DPTPSystem/UltravioletLedLight/(list of files, cad)

Other CAD files:
P12F683/levilagito.obj
P12F683/startup.obj
